Roshan-khatri78/ball-balancing-hexabot/Phase1/simulation/embeded system of phase1.jpg

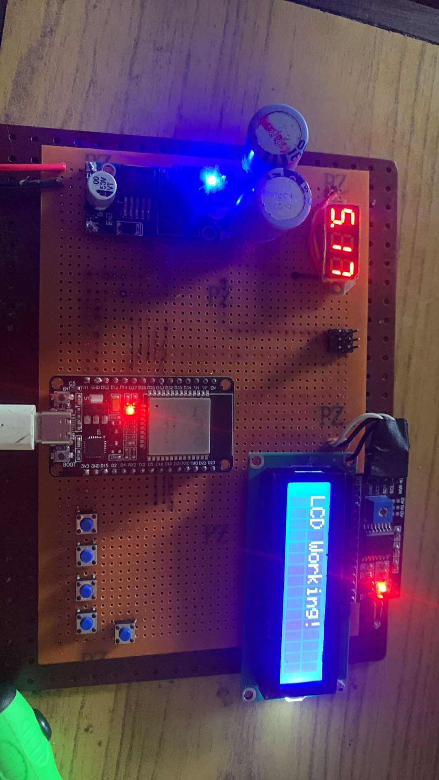
Phase1/simulation/embeded system of phase1.jpg
