Roshan-khatri78/ball-balancing-hexabot/Phase1/simulation/phase1 layout.png

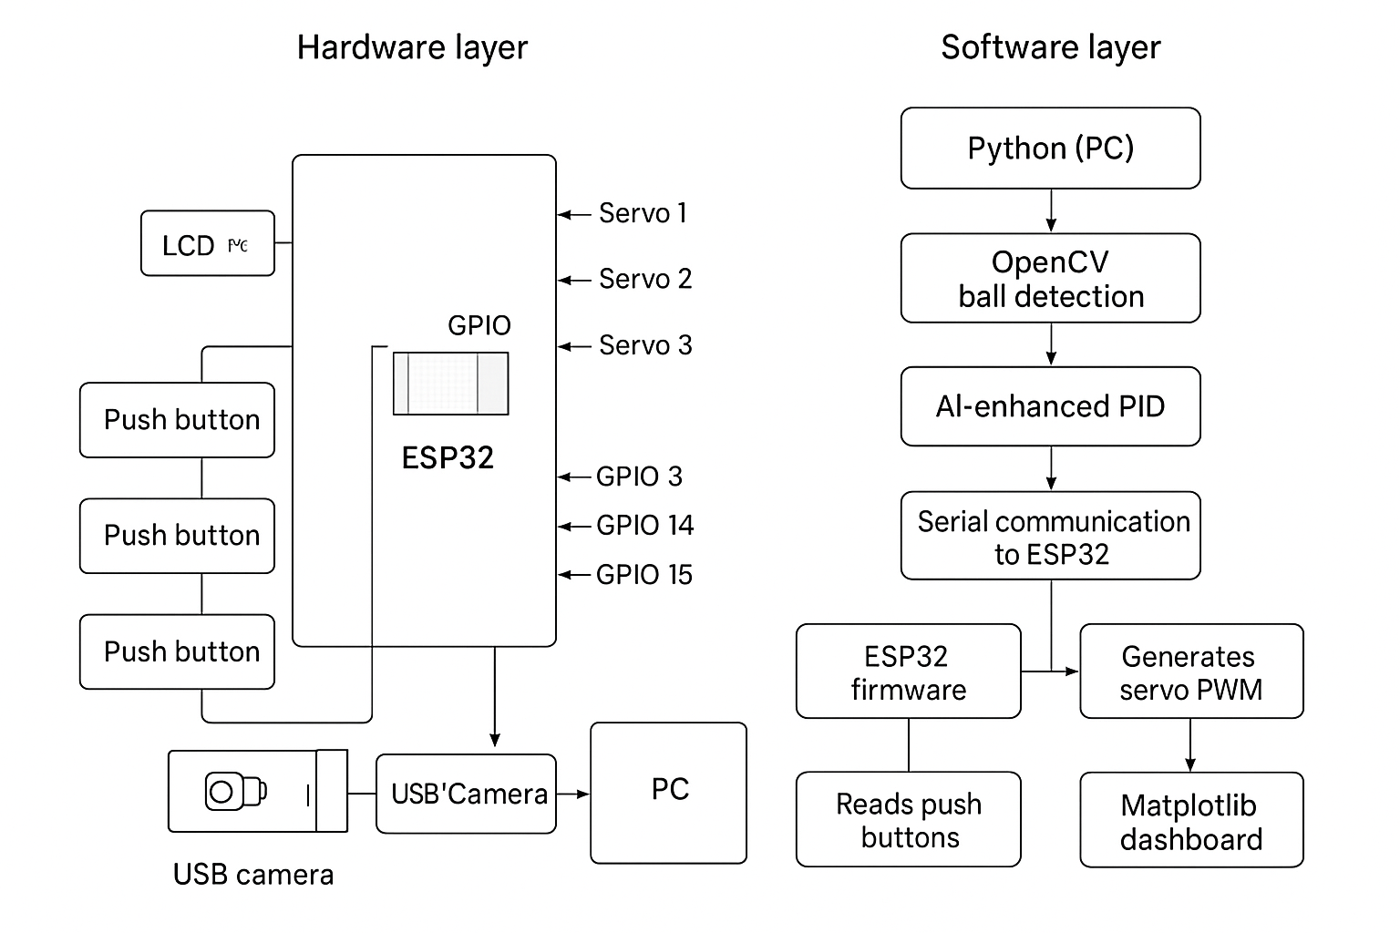
Phase1/simulation/phase1 layout.png
