Roshan-khatri78/ball-balancing-hexabot/Phase1/simulation/phase 1 servo flow diagram.png

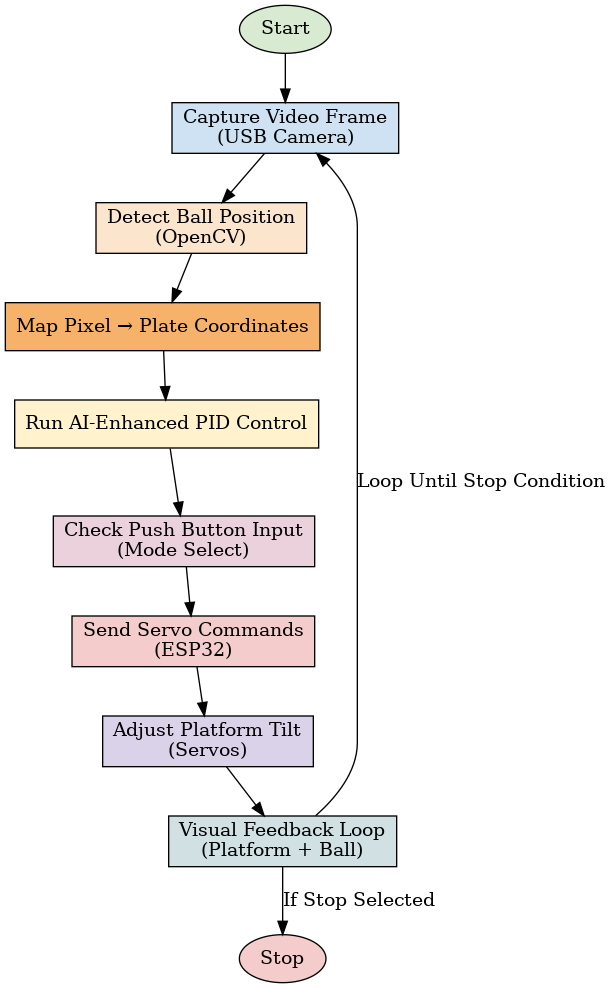
Phase1/simulation/phase 1 servo flow diagram.png
