Roshan-khatri78/ball-balancing-hexabot/Phase1/simulation/servo phase1 schematics handwritten.jpg

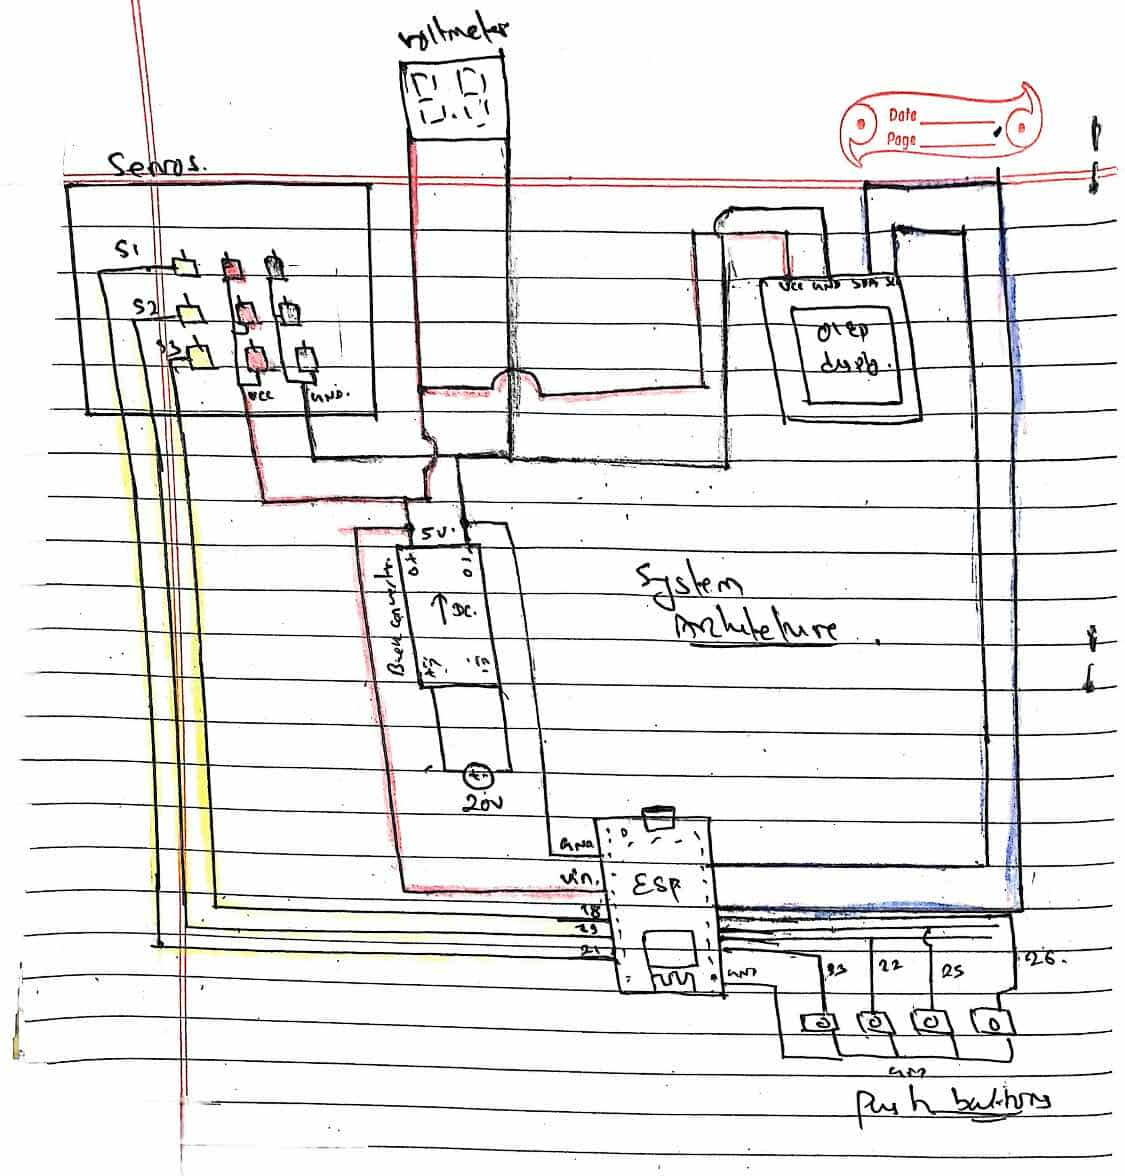
Phase1/simulation/servo phase1 schematics handwritten.jpg
