Roshan-khatri78/ball-balancing-hexabot/Phase2/cad/cad1.jpg

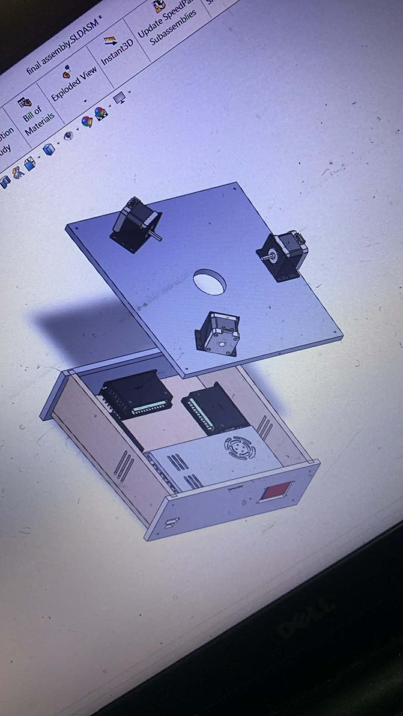
Phase2/cad/cad1.jpg
