Roshan-khatri78/ball-balancing-hexabot/Phase2/cad/cad2.jpg

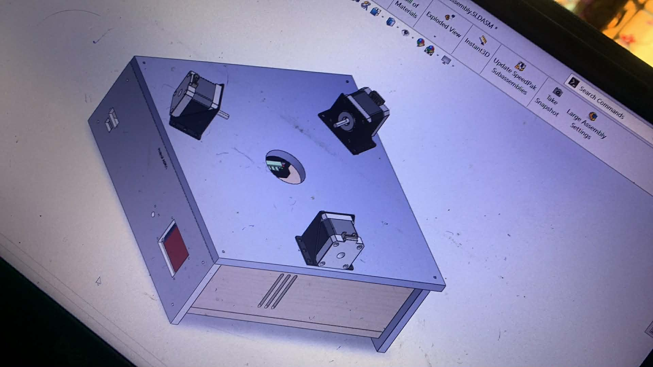
Phase2/cad/cad2.jpg
