Roshan-khatri78/ball-balancing-hexabot/Phase2/cad/cad3.jpg

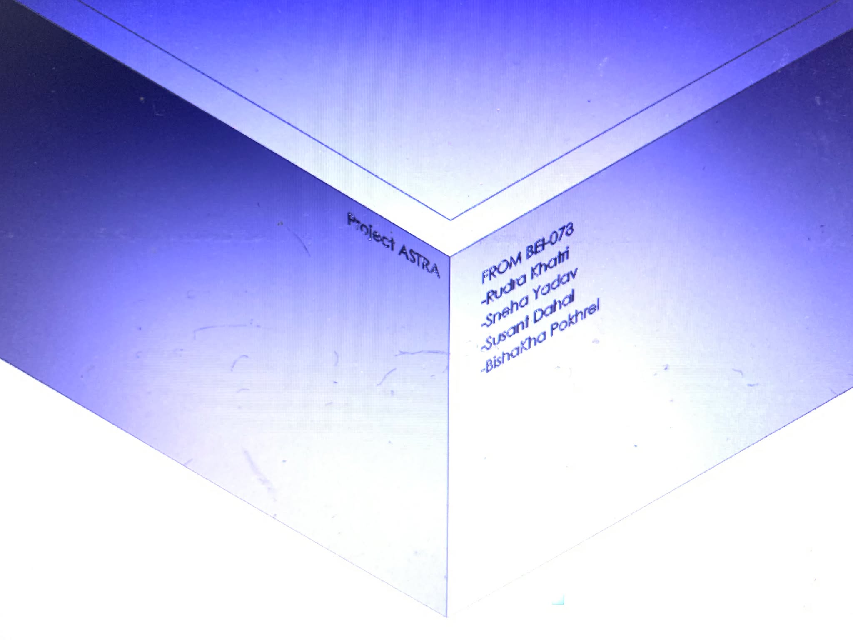
Phase2/cad/cad3.jpg
