Roshan-khatri78/ball-balancing-hexabot/Phase2/firmware/firmwarephase2.jpg

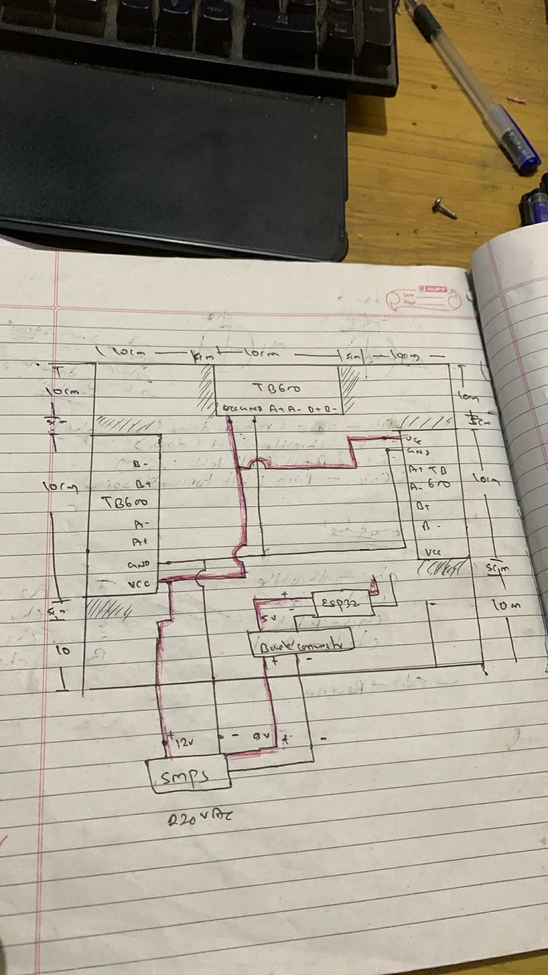
Phase2/firmware/firmwarephase2.jpg
