Roshan-khatri78/ball-balancing-hexabot/Phase2/images/flowchart and architecture/architecturephase2.png

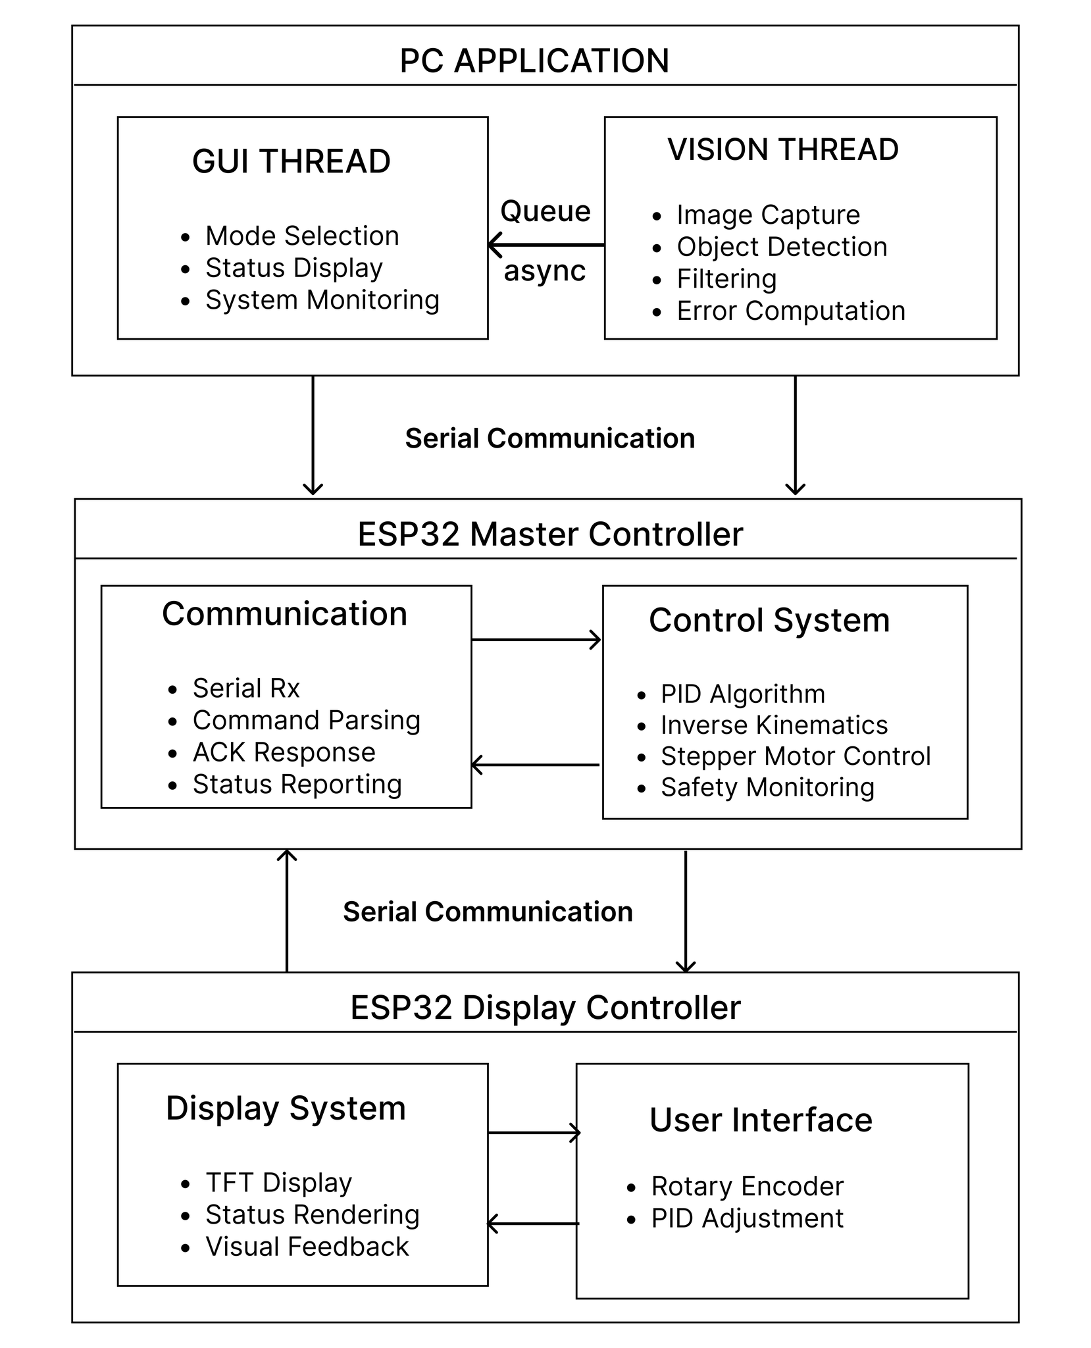
Phase2/images/flowchart and architecture/architecturephase2.png
