Roshan-khatri78/ball-balancing-hexabot/Phase2/images/hardware/frontastra.jpg

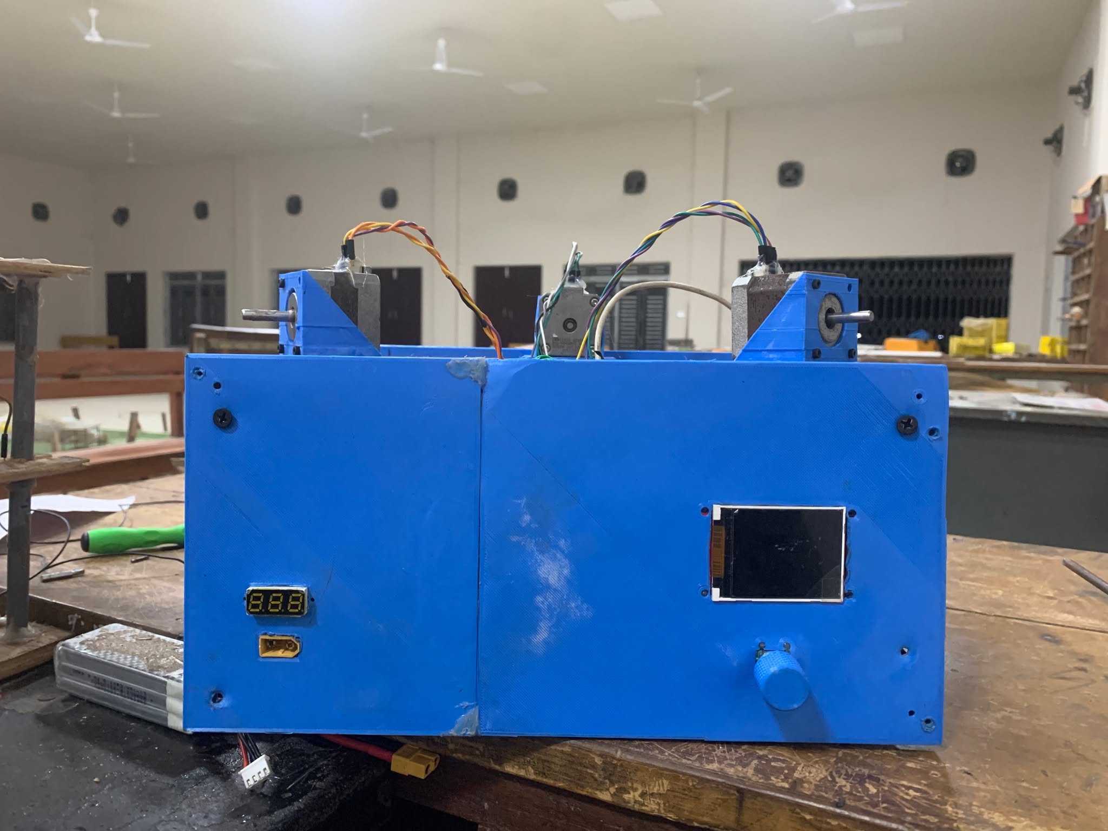
Phase2/images/hardware/frontastra.jpg
