Roshan-khatri78/ball-balancing-hexabot/Phase2/images/hardware/inside frame2.jpg

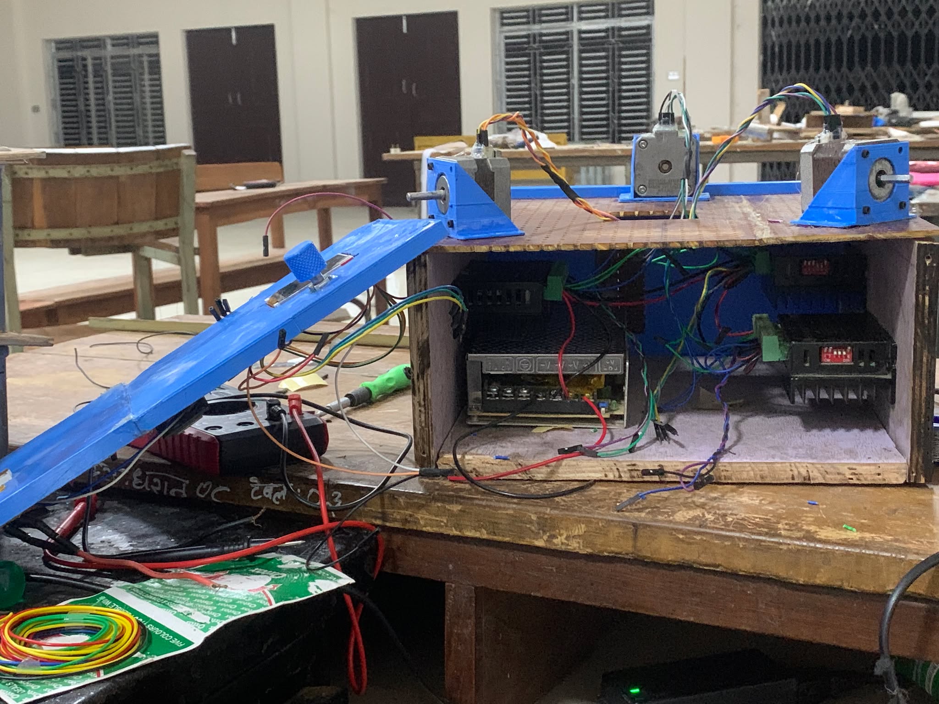
Phase2/images/hardware/inside frame2.jpg
