Roshan-khatri78/ball-balancing-hexabot/Phase2/images/hardware/isndieframe.jpg

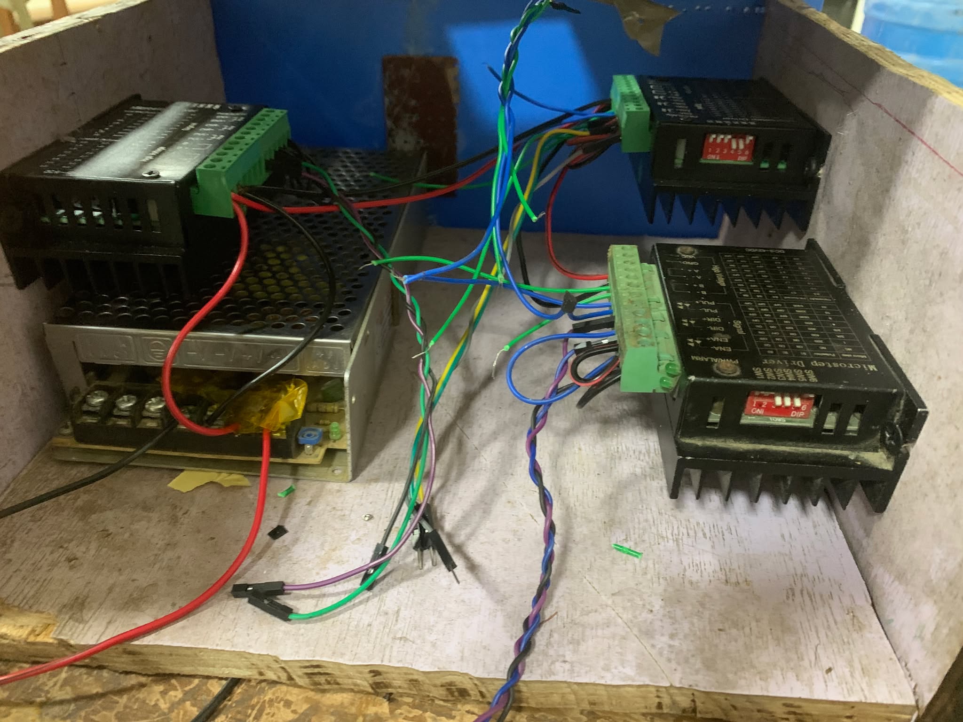
Phase2/images/hardware/isndieframe.jpg
