Roshan-khatri78/ball-balancing-hexabot/Phase2/images/hardware/projectastra1.jpg

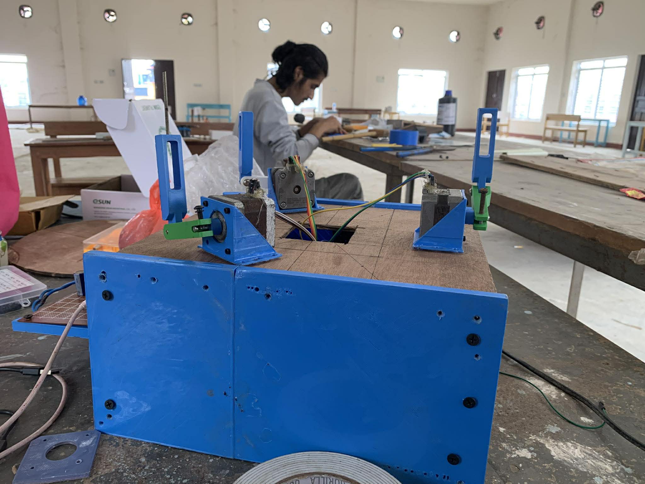
Phase2/images/hardware/projectastra1.jpg
