Roshan-khatri78/ball-balancing-hexabot/Phase2/images/hardware/projectr astra.jpg

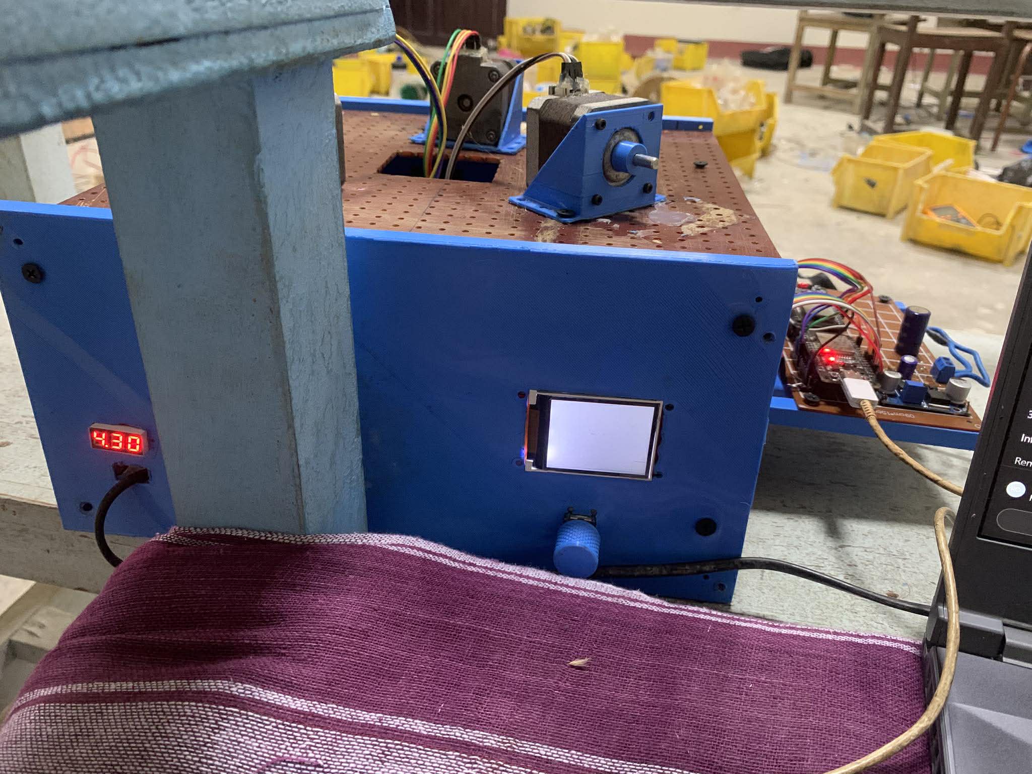
Phase2/images/hardware/projectr astra.jpg
