Roshan-khatri78/ball-balancing-hexabot/Phase2/images/interface/phase2 interface.png

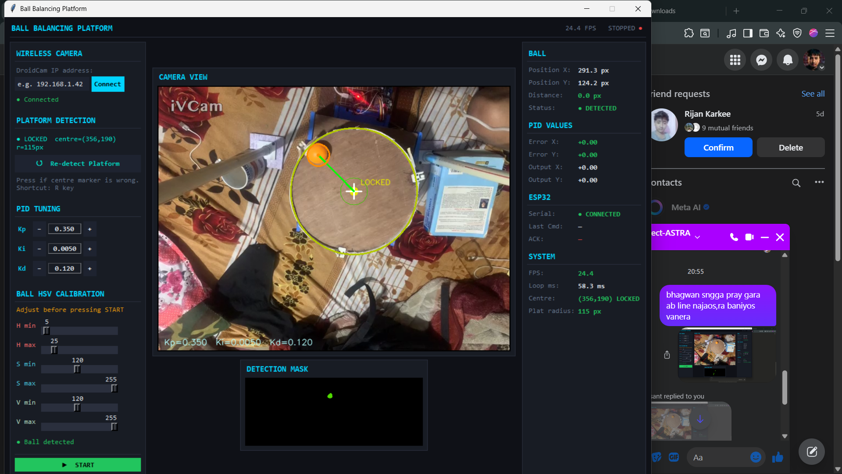
Phase2/images/interface/phase2 interface.png
