Roshan-khatri78/ball-balancing-hexabot/Phase2/images/results/finalresult.jpg

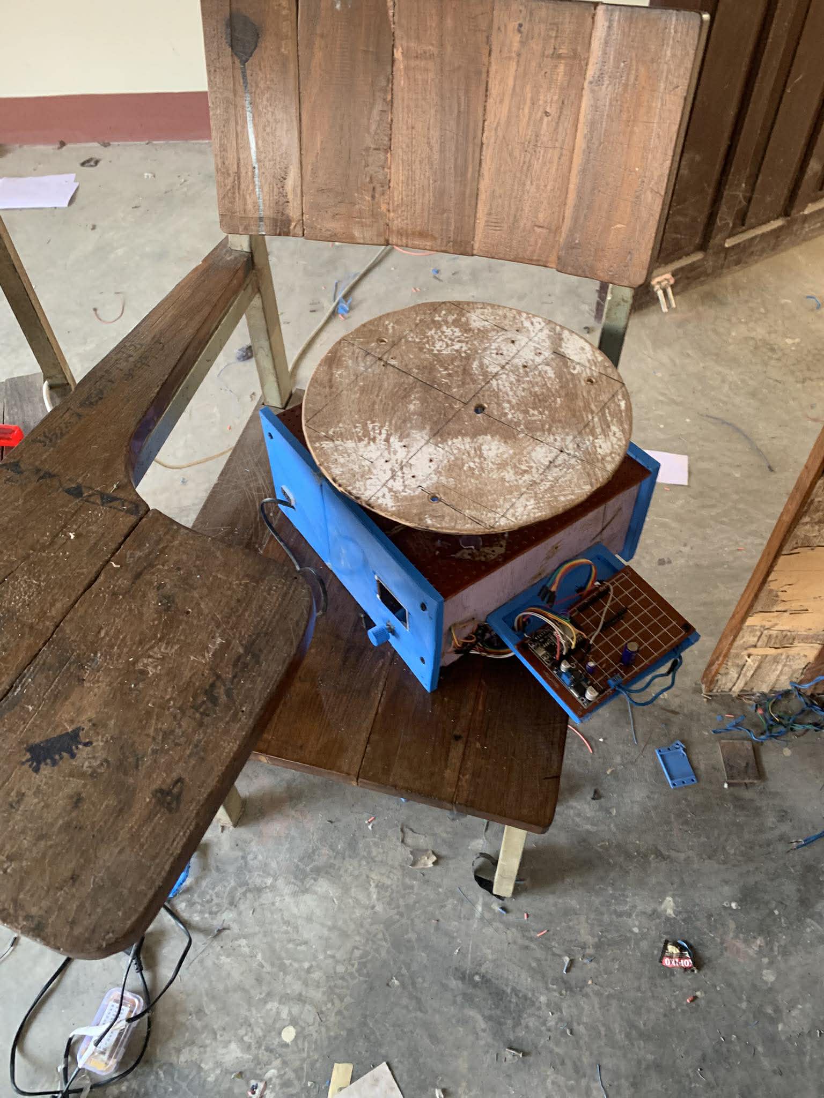
Phase2/images/results/finalresult.jpg
