Roshan-khatri78/ball-balancing-hexabot/Phase2/images/results/lcd tesing.jpg

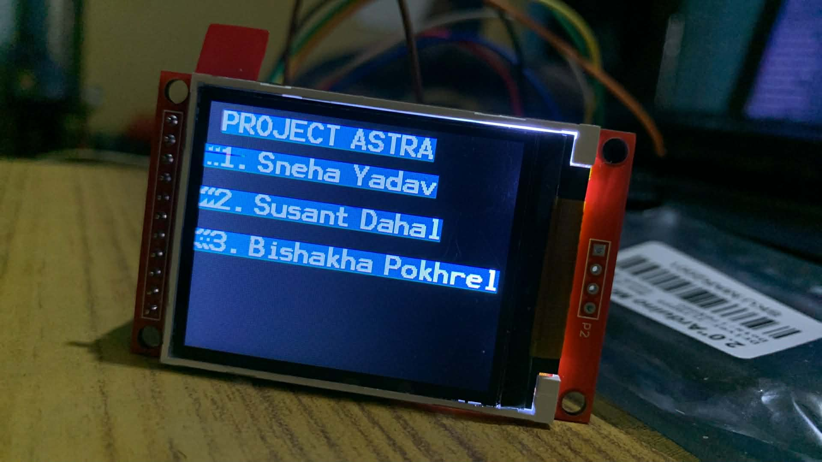
Phase2/images/results/lcd tesing.jpg
