Roshan-khatri78/ball-balancing-hexabot/Phase2/images/results/testing.jpg

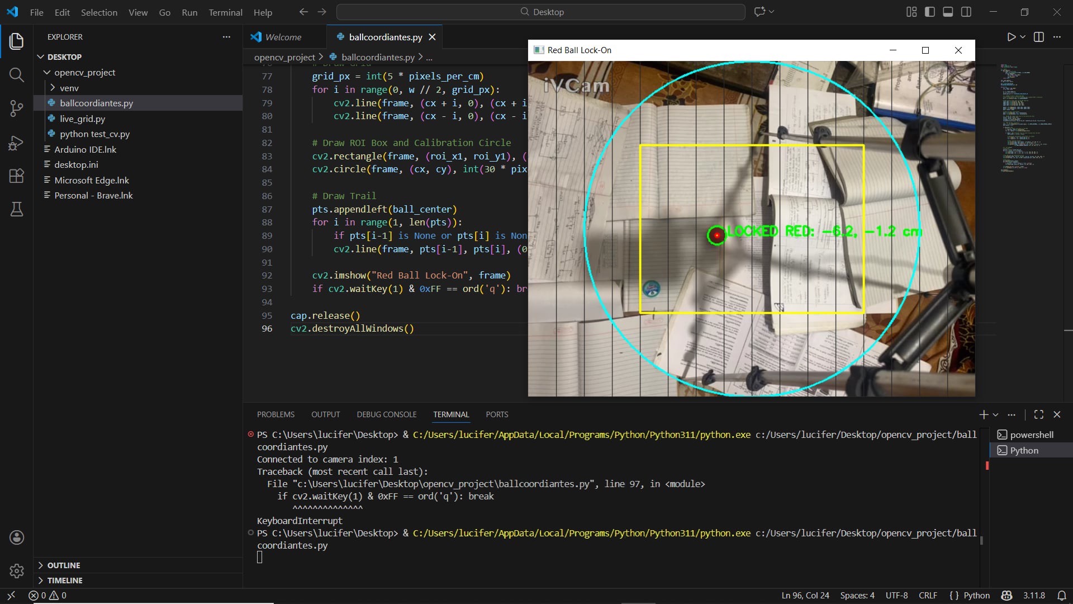
Phase2/images/results/testing.jpg
