Roshan-khatri78/ball-balancing-hexabot/(commit log)

2025-08-06 feat: Add Arduino firmware and Python simulation
    Hardware Implementation:
    - firmware/midtermdefense.ino: ESP32 hexabot control system
    * Servos: D21, D22, D23 (MG996R motors)
    * LCD I2C: SDA=D4, SCL=D15 (16x2 display)
    * Buttons: D2(left), D26(select), D33(right), D13(back), D27(stop)
    * Power: 20V→5V step-down converter, 3A capacity
    Simulation:
    - simulation/Astra_plot.py: Python matplotlib ball balancing simulation
    * Real-time physics visualization and control testing
    Ready for hardware testing and Python-ESP32 integration.
    #IOE2078 #BallBalancing #ESP32 #Python #PurwanchalCampus
2025-08-06 Update README.md
    Ai inegrate4d with pid
2025-08-06 Create Pin Configuration.md
2026-06-03 Revise README for clarity and detail enhancement
    Updated project title and description for clarity. Revised features and performance metrics sections. Enhanced hardware and software details for both servo and stepper builds.
2026-06-03 Document transition from Phase 1 to Phase 2
    Added a section explaining the transition from Phase 1 to Phase 2, detailing limitations of Phase 1 and improvements in Phase 2. Included performance results and a closed-loop flow diagram.
2026-06-03 add: Phase2 project folders for report, firmware, python, cad, docs
